synergia/Synergolf/SynerGolf.pptx

SynerGolf

Michał Szlachetka 205684
Marcin Trojan 205608
Jakub Trzyna 205687

## Slide 2

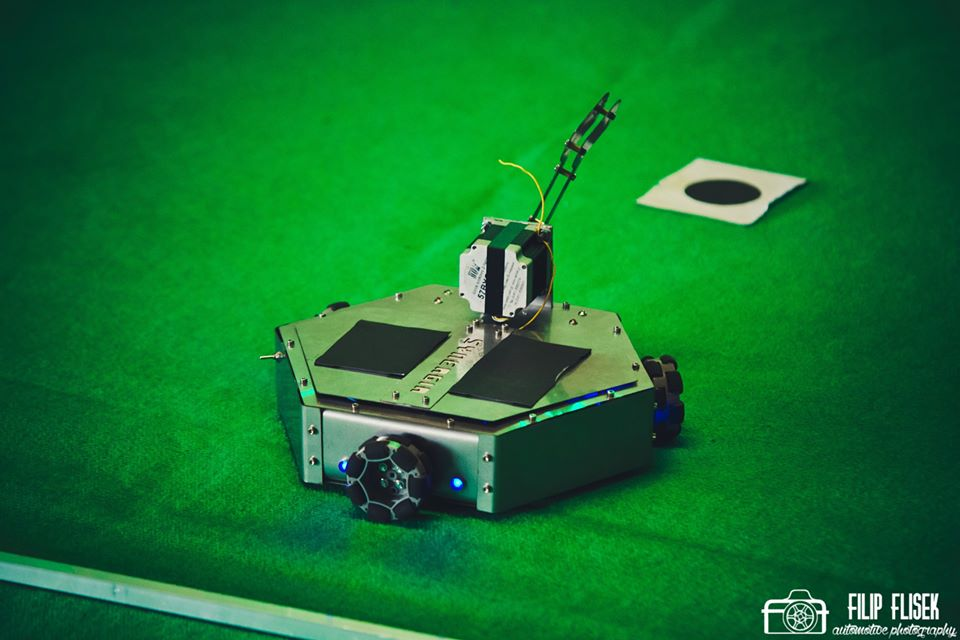
[picture p2: figure]

## Założenia

W skład „SynerGolfa” wchodzą :
- Dwuczęściowy aluminiowy kij
- Otwierana klapa
- Silnik krokowy
- Silniki DC
- Koła Omni Wheels
- Obudowa

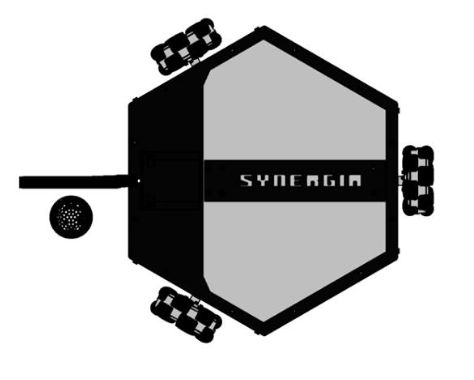
[picture p3: figure]
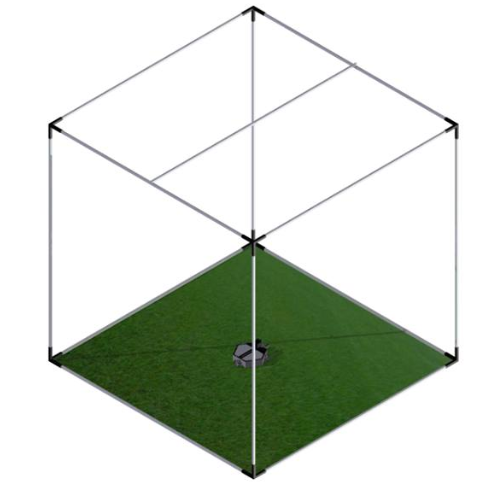
[picture p4: figure]
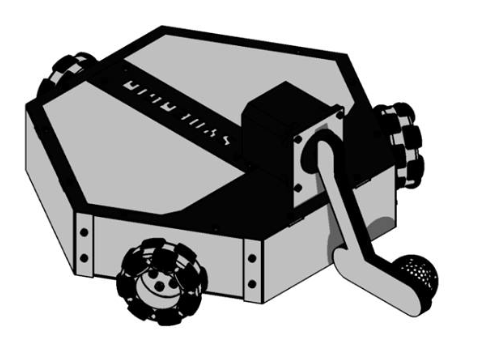
[picture p5: figure]

## Mechanika

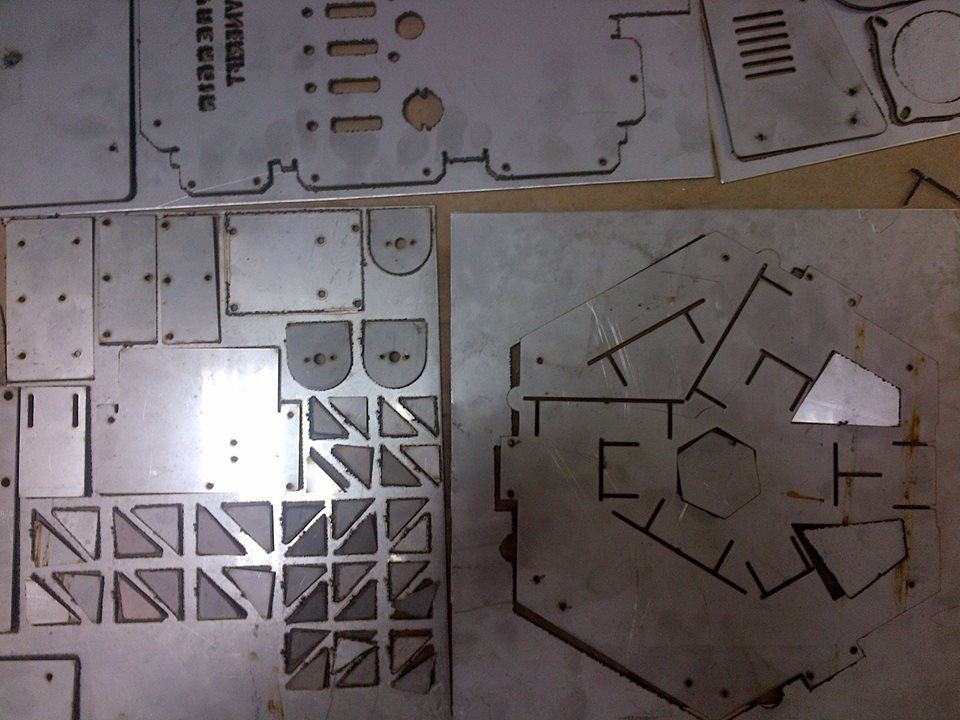
[picture p6: figure]

## Spawanie

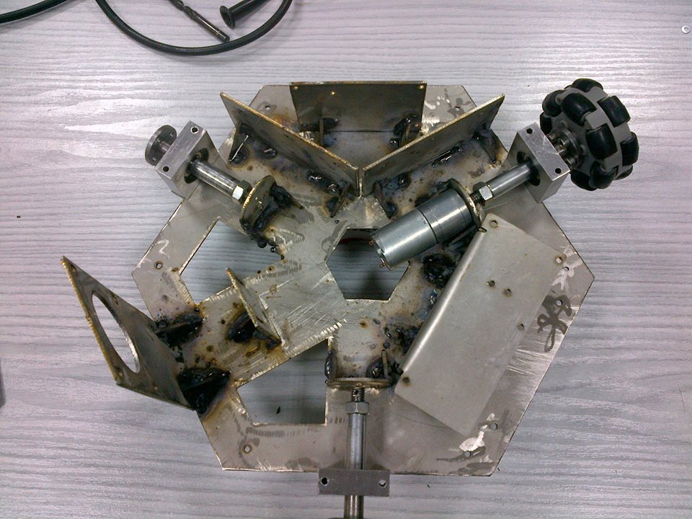
[picture p7: figure]

## Analiza obrazu

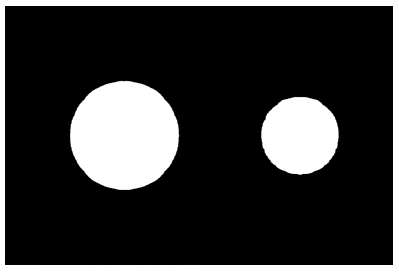
[picture p8: figure]
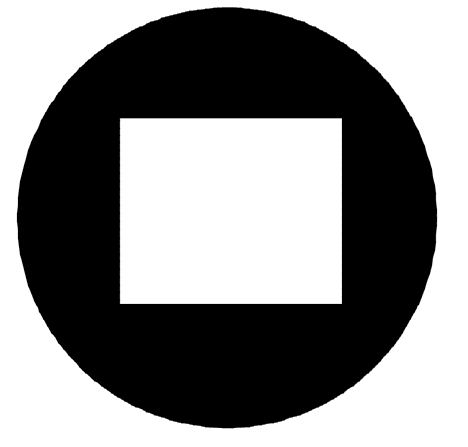
[picture p9: figure]
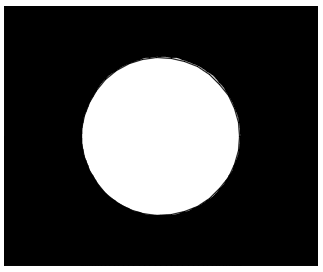
[picture p10: figure]
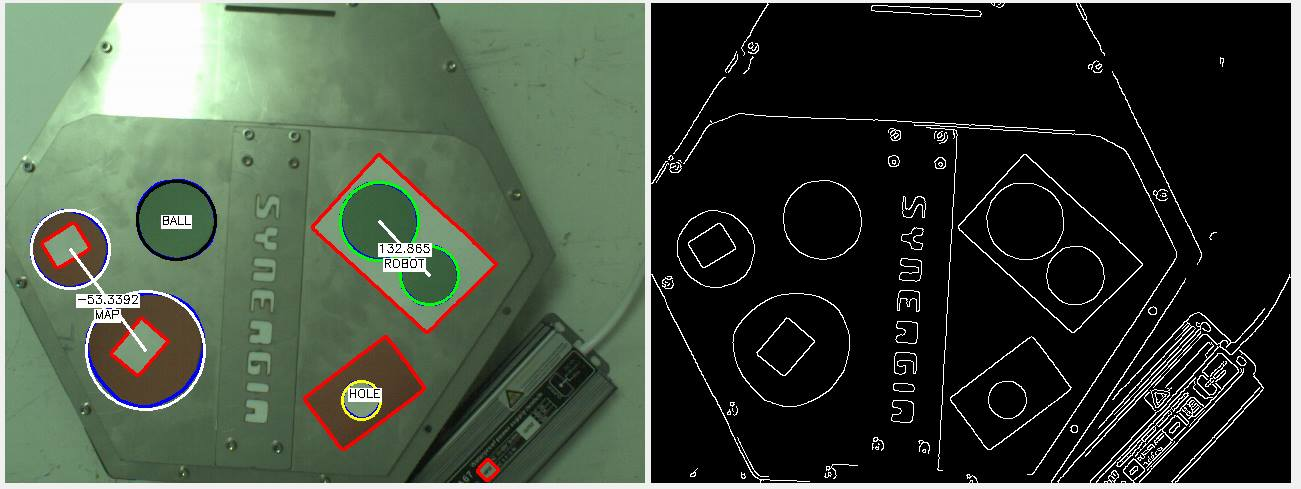
[picture p11: figure]

## Elektronika

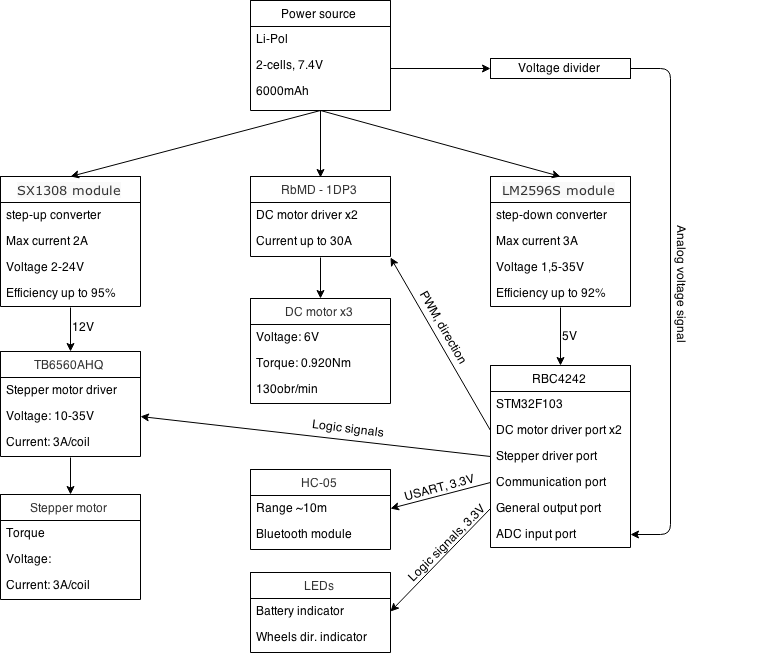
[picture p12: figure]

## Rozplanowanie

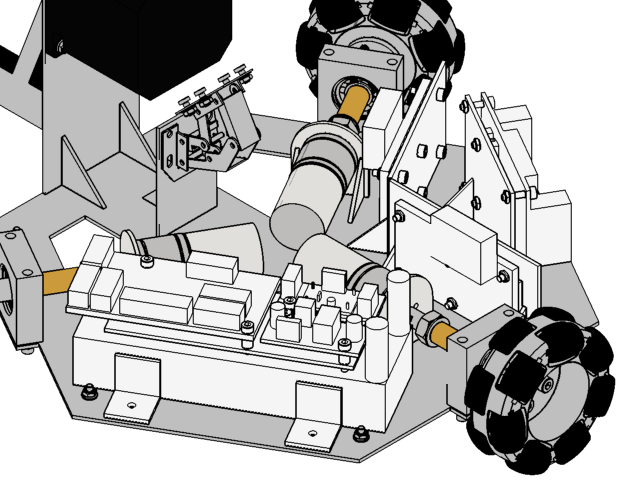
[picture p13: figure]
