synergia/Synergolf/model/GOLF/eksport do dxf.pdf

1. Utworzyć rozwinięcie blachy

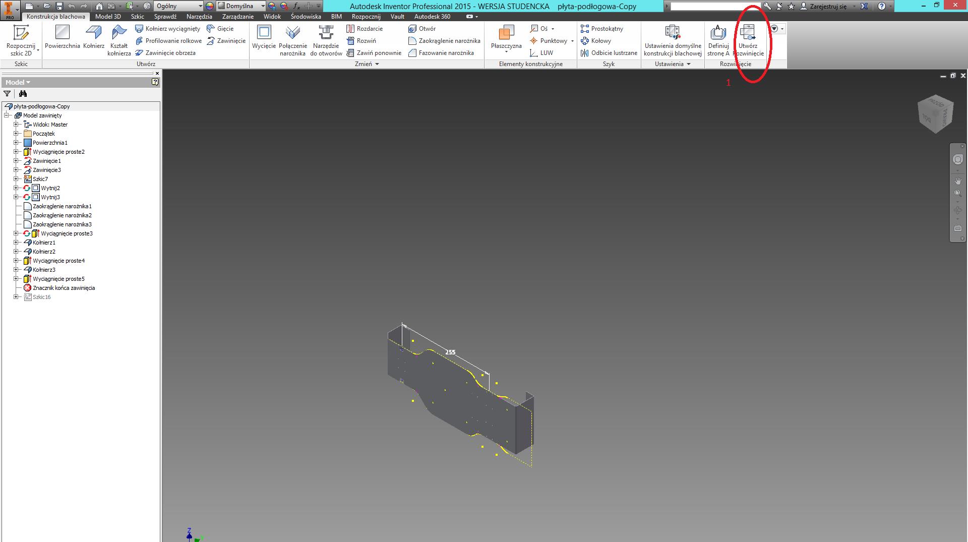
[picture p14: figure]

2. Tworzenie pliku dokumentacji technicznej

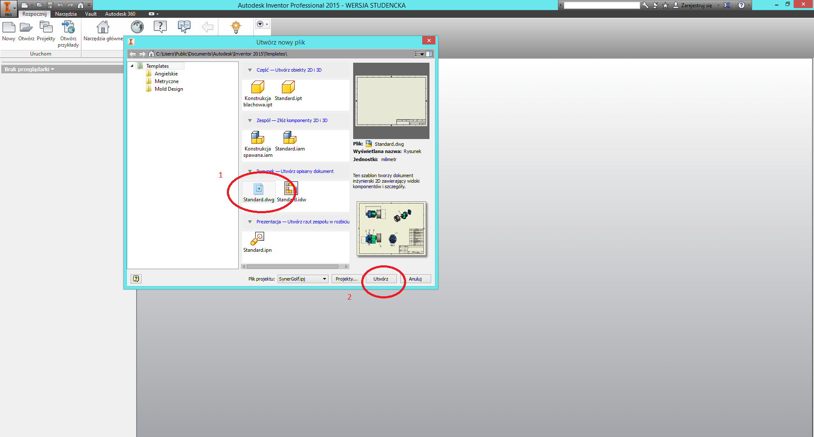
[picture p15: figure]

3. Ustawienie arkusza na odpowiedni wymiar (chyba nie jest konieczne, ale wydaje się być bardziej naturalne). PPM na arkuszu

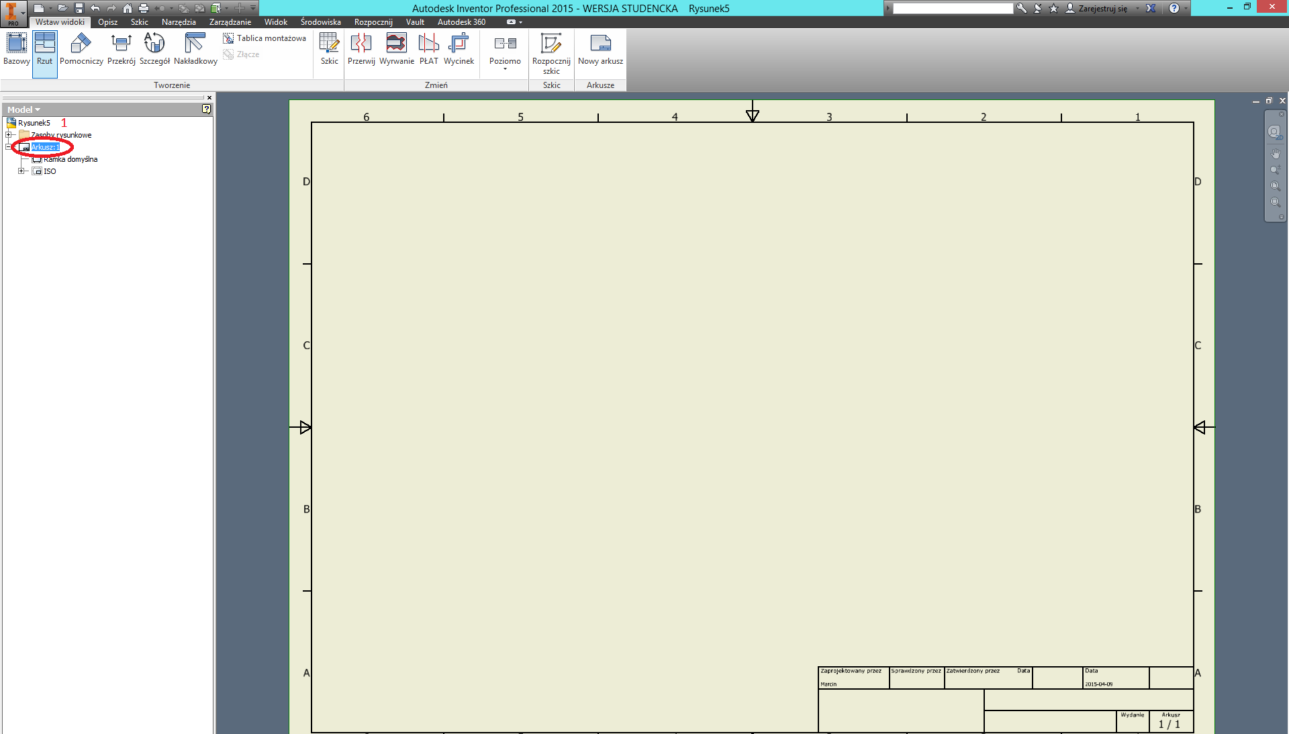
[picture p16: figure]

4. C.d.

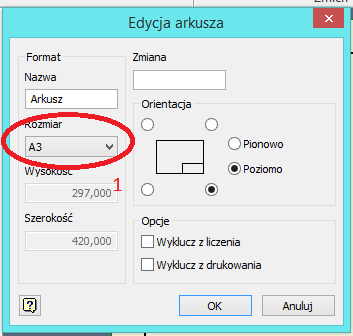
[picture p17: figure]

5. Tworzenie rzutu 2d

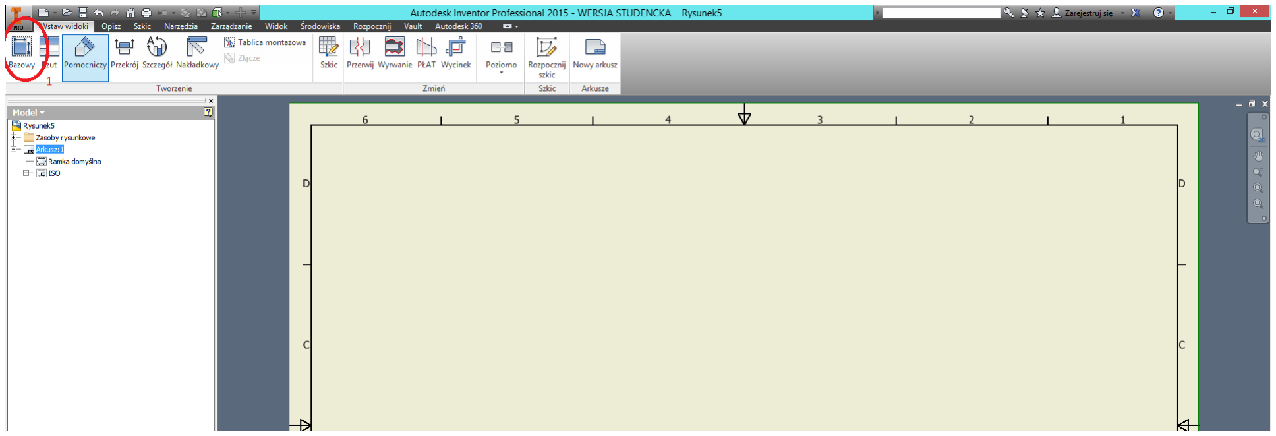
[picture p18: figure]

6. Lokalizacja pliku. Tu jest zaznaczona skala 1:1. Na następnym slajdzie ustawiło się przypadkiem 1:4, ale w rezultacie nie miało to wpływu na końcowy efekt

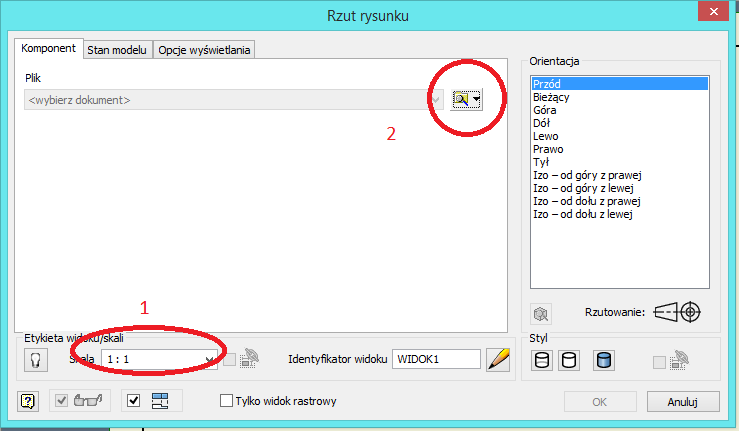
[picture p19: figure]

7. Wybranie opcji „rozwinięcie blachy”. Ta opcja jest niedostępna jeżeli nie utworzony został plik rozwinięcia blachy.

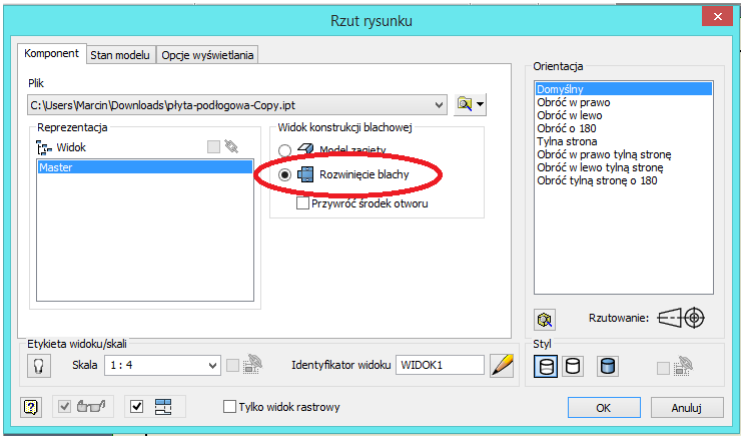
[picture p20: figure]

8. Teraz trzeba umieścić model na środku arkusza, nie naciskając LMP. Po umieszczeniu elementu należy nacisnąć PPM i wybrać „OK”.

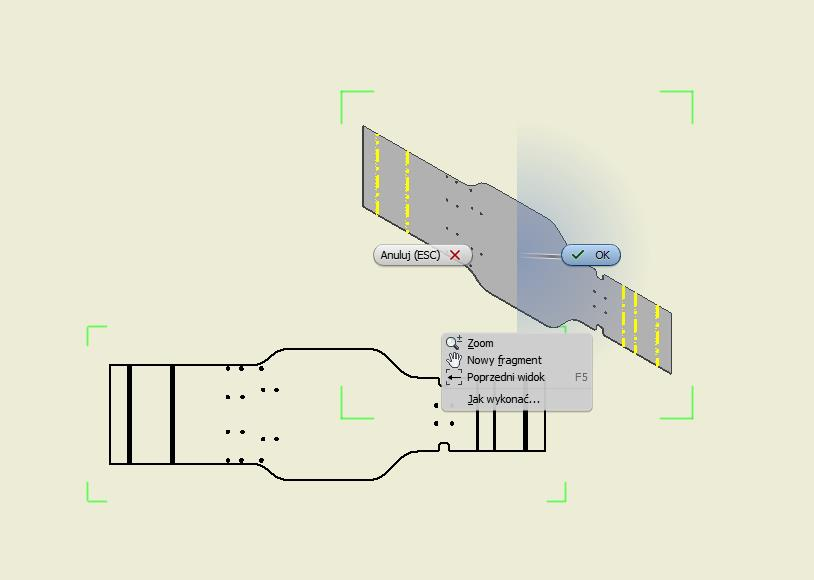
[picture p21: figure]

9. Zapisywanie

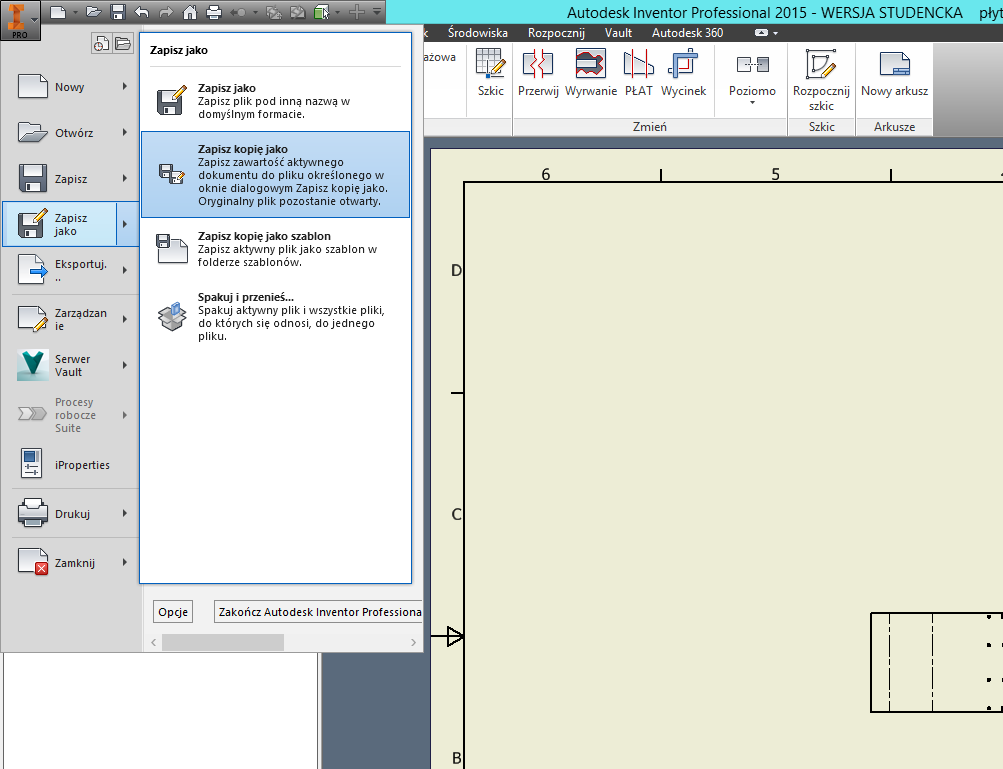
[picture p22: figure]

10. C.d.

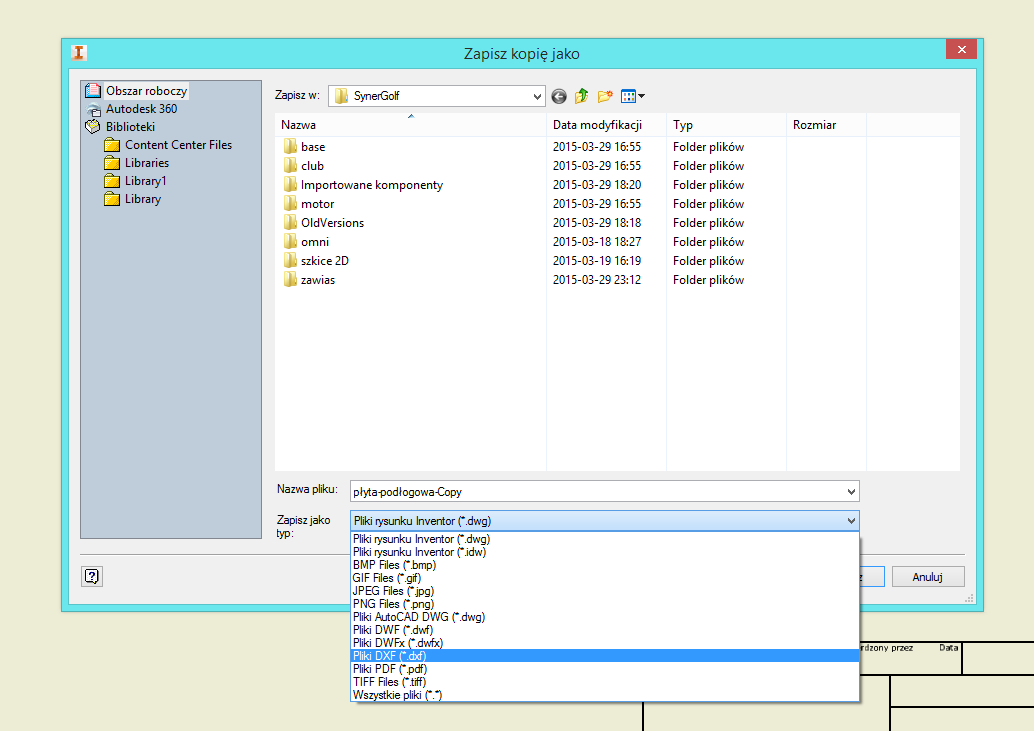
[picture p23: figure]

11. Otwieramy AutoCada.

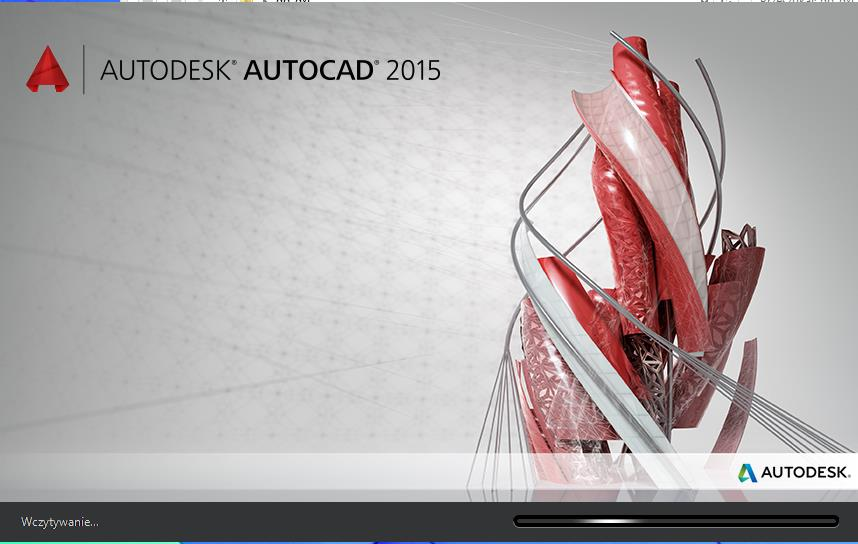
[picture p24: figure]

12. Usuwamy niepotrzebną ramkę.

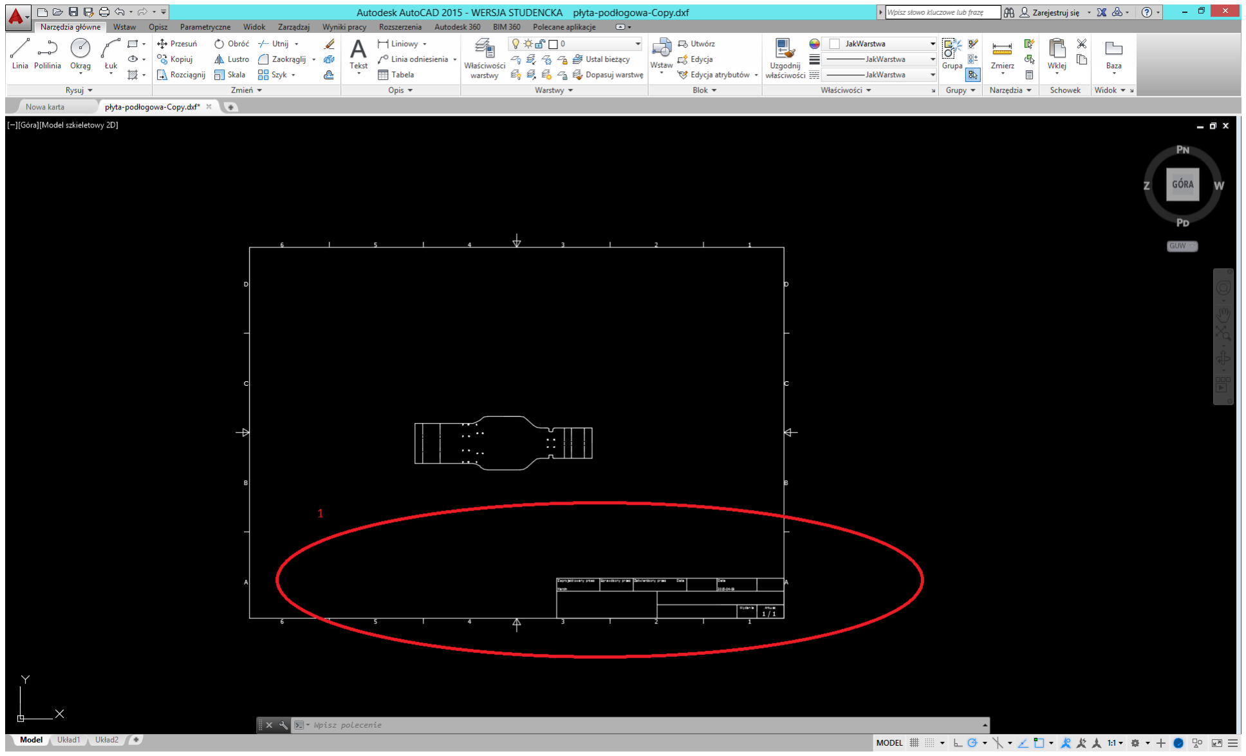
[picture p25: figure]

13. Usuwamy linie gięcia blachy.

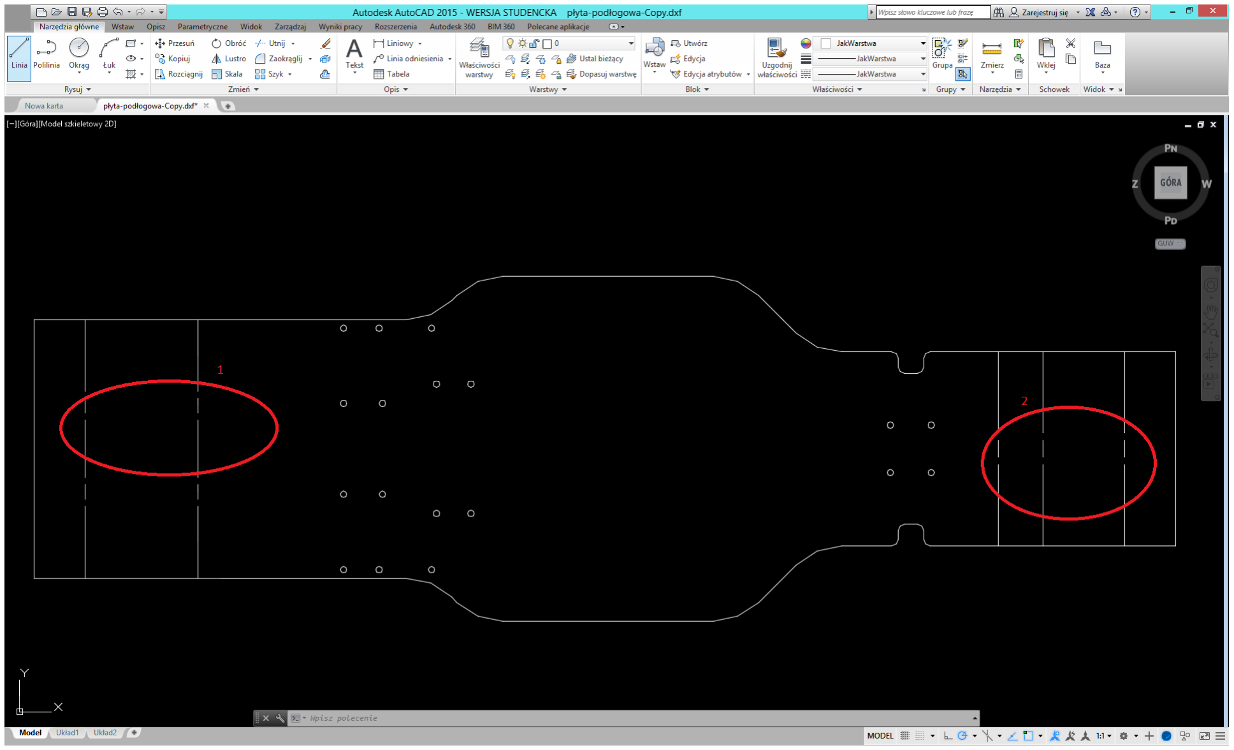
[picture p26: figure]

14. Sprawdzamy czy wszystkie splajny są przybliżone okręgami.

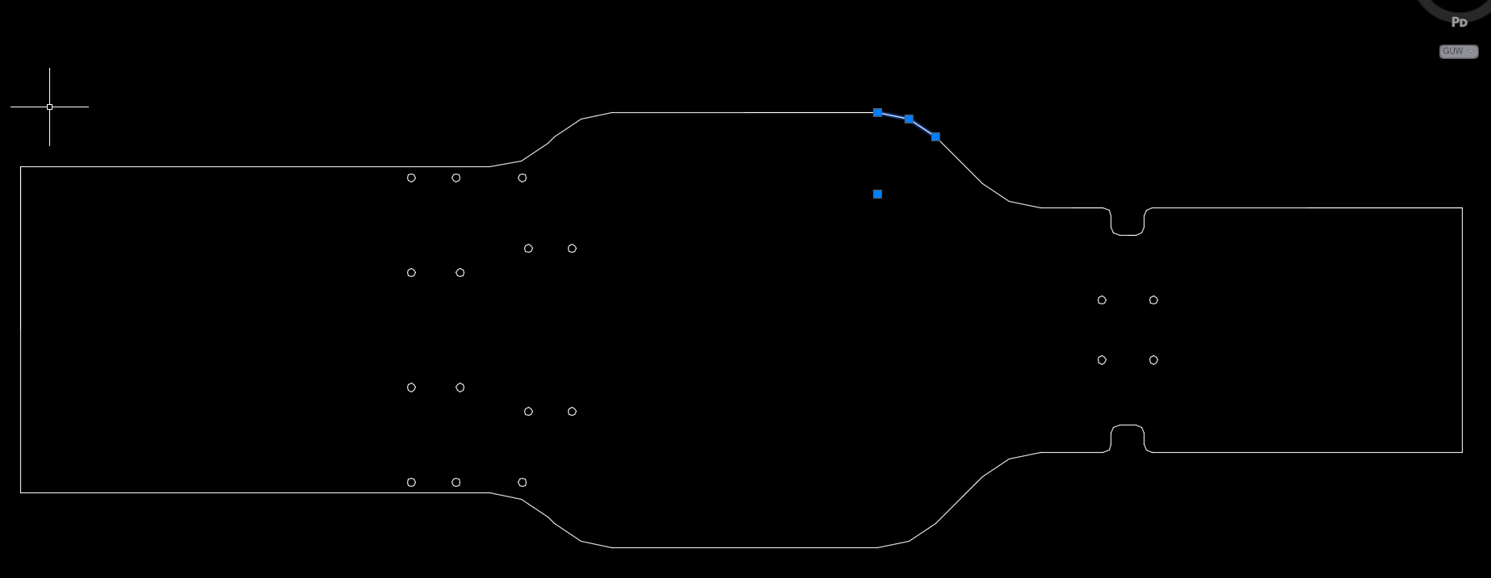
[picture p27: figure]

15. Grupujemy element. Bardzo ułatwia to później edycję programu.

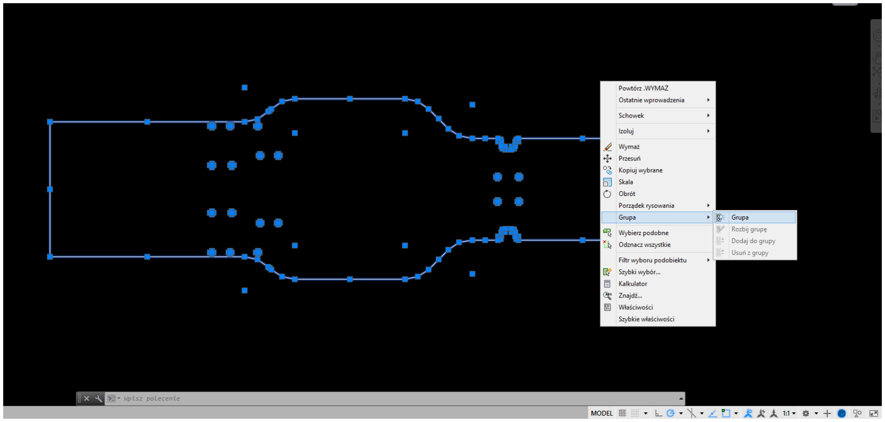
[picture p28: figure]

16. Zapisujemy jako DXF. Im starsza wersja tym lepiej.

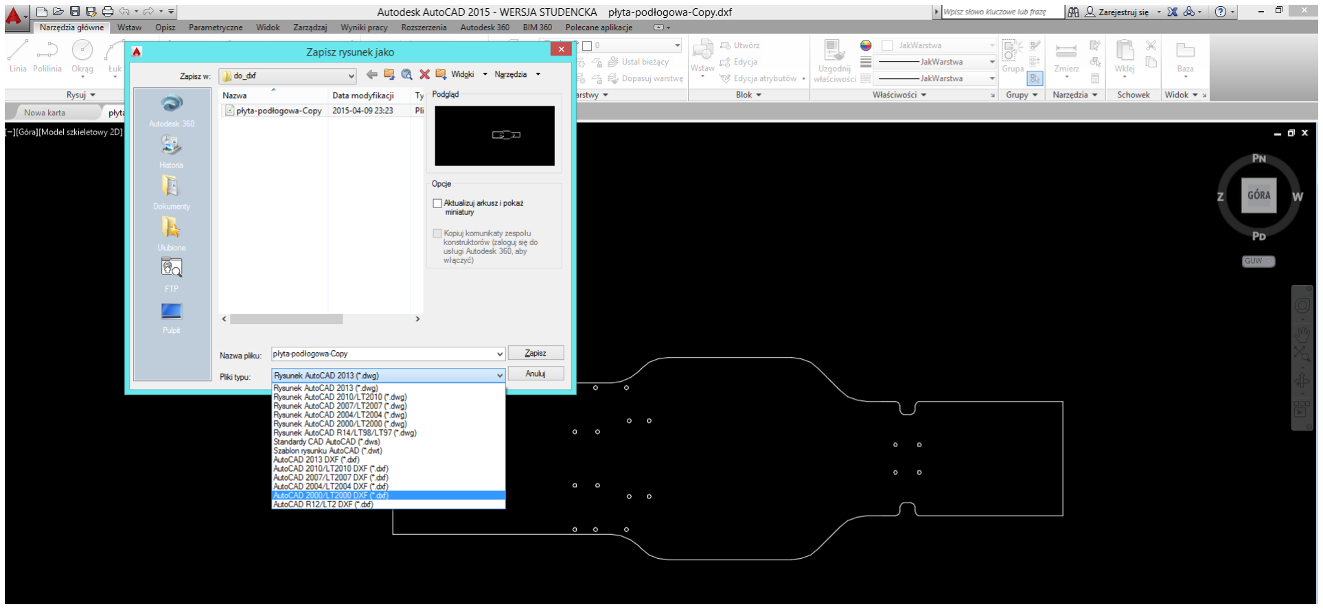
[picture p29: figure]

17. Przy wyłączeniu rysunku autocad proponuje zapisanie pliku w nowszym formacie. Odmawiamy

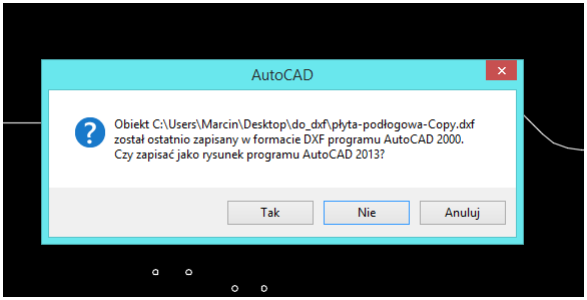
[picture p30: figure]
