synergia/Synergolf/model/GOLF/rendery/dc1.bmp

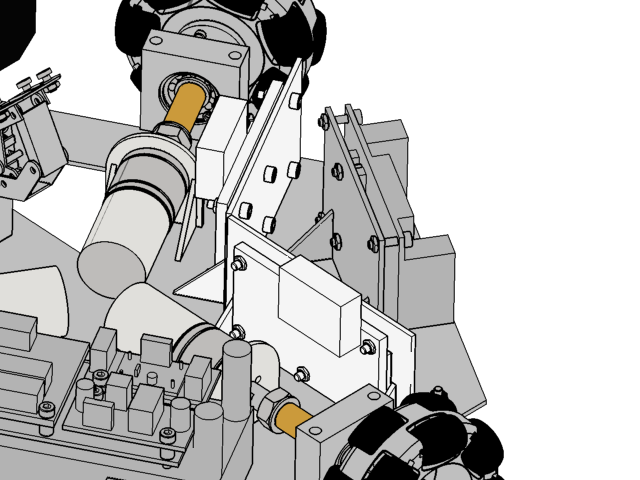
model/GOLF/rendery/dc1.bmp
