synergia/Synergolf/model/GOLF/rendery/supp1.bmp

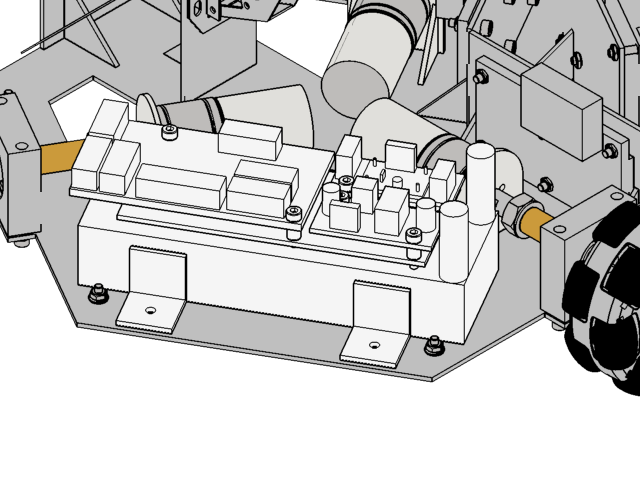
model/GOLF/rendery/supp1.bmp
