synergia/Synergolf/model/GOLF/rendery/supp2.bmp

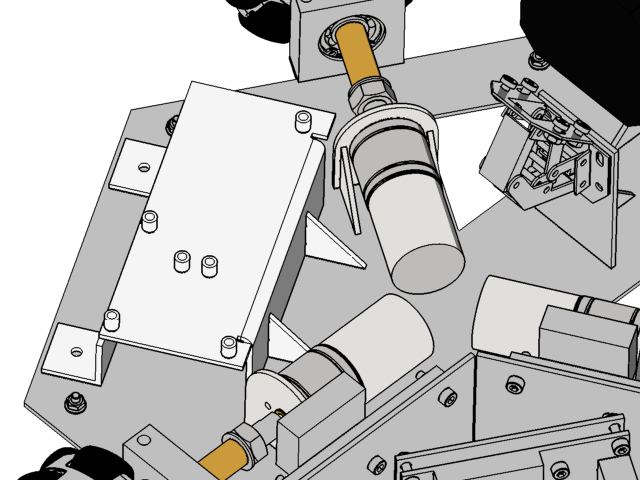
model/GOLF/rendery/supp2.bmp
