synergia/Synergolf/model/GOLF/dxf/batt-logic support.dxf

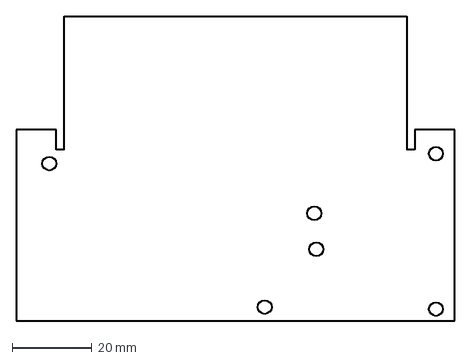
[picture p34: CAD file, 2015-05-10]
model/GOLF/dxf/batt-logic support.dxf
110.0 x 76.5 mm
