synergia/Synergolf/model/GOLF/dxf/mostekH.dxf

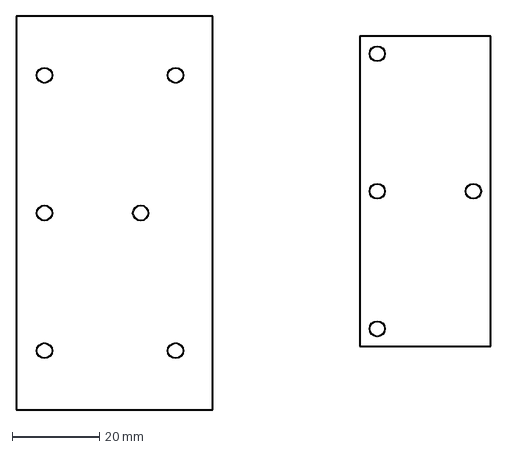
[picture p35: CAD file, 2015-05-10]
model/GOLF/dxf/mostekH.dxf
108.7 x 90.0 mm
