synergia/Synergolf/model/GOLF/dxf/base_constr.dxf

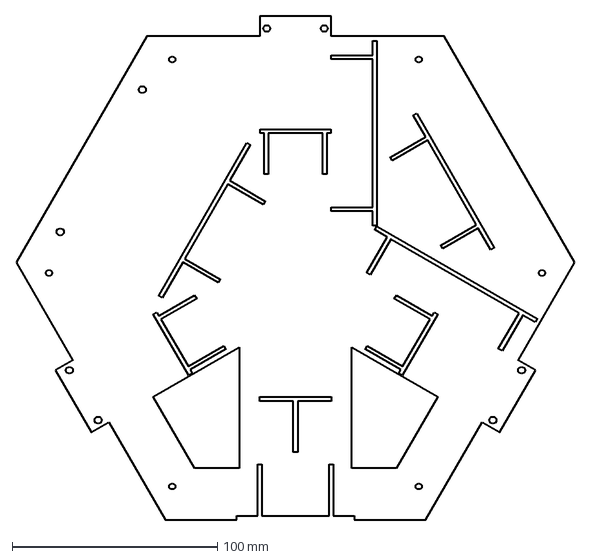
[picture p36: CAD file, 2015-05-10]
model/GOLF/dxf/base_constr.dxf
271.7 x 245.2 mm
