synergia/Synergolf/model/GOLF/dxf/blacha pionowa step driver.dxf

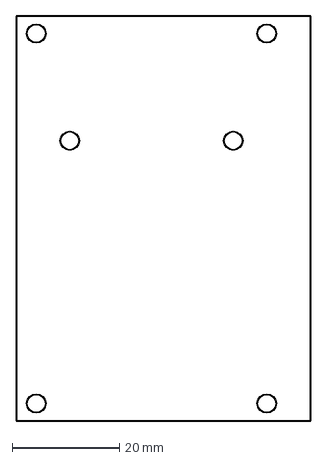
[picture p37: CAD file, 2015-05-10]
model/GOLF/dxf/blacha pionowa step driver.dxf
55.0 x 75.5 mm
