synergia/Synergolf/model/GOLF/dxf/laser.dxf

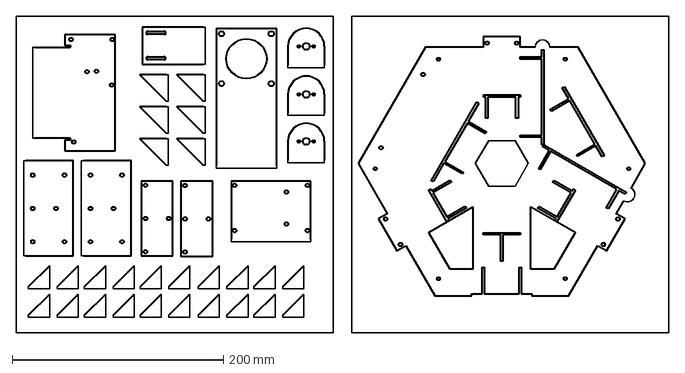
[picture p38: CAD file, 2015-05-10]
model/GOLF/dxf/laser.dxf
617.4 x 300.0 mm
