synergia/Synergolf/model/GOLF/dxf/wspornik.dxf

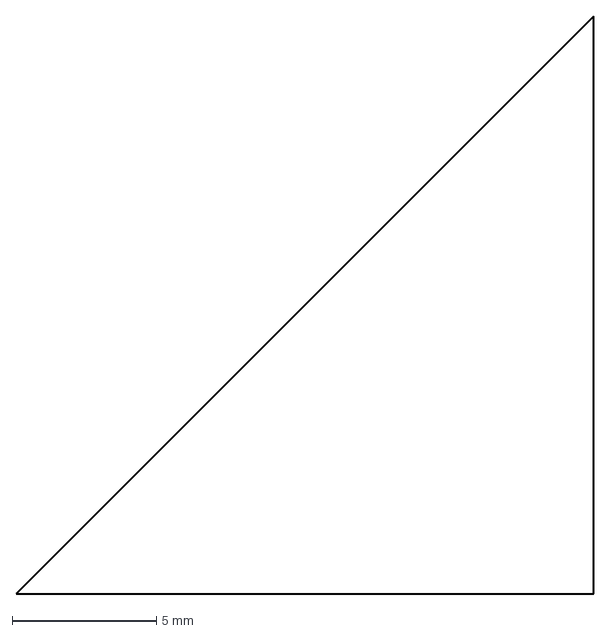
[picture p39: CAD file, 2015-05-10]
model/GOLF/dxf/wspornik.dxf
20.0 x 20.0 mm
