synergia/Synergolf/(list of files, cad)

Other CAD files:
model/GOLF/Templates/Angielskie/am_ansi.dwg
model/GOLF/Templates/Metryczne/JIS.dwg
model/GOLF/Templates/Standard.dwg
model/GOLF/Templates/Angielskie/ANSI (cal).dwg
model/GOLF/Templates/Metryczne/am_bsi.dwg
model/GOLF/Templates/Metryczne/am_gb.dwg
model/GOLF/Templates/Metryczne/am_din.dwg
model/GOLF/Templates/Metryczne/BSI.dwg
model/GOLF/dxf/blacha pionowa.dwg
model/GOLF/Templates/Metryczne/ANSI (mm).dwg
model/GOLF/Templates/Metryczne/GB.dwg
model/GOLF/dxf/blacha pionowa ste driver.dwg
model/GOLF/Templates/Metryczne/GOST.dwg
model/GOLF/Templates/Metryczne/ISO.dwg
model/GOLF/Templates/Metryczne/am_jis.dwg
model/GOLF/Templates/Metryczne/am_iso.dwg
model/GOLF/Templates/Metryczne/DIN.dwg
model/GOLF/20126_3D1.ipt
model/GOLF/ASM-SMALL-WHEEL_ASM.iam
model/GOLF/ContentCenter/pl-PL/DIN 439-2/DIN 439 - M2,5 x 0,45.ipt
model/GOLF/ContentCenter/pl-PL/DIN 439-2/DIN 439 - M3 x 0,5.ipt
model/GOLF/ContentCenter/pl-PL/DIN 912/DIN 912 - M2,5 x 0,45 x 12 x 10,875.ipt
model/GOLF/ContentCenter/pl-PL/DIN 912/DIN 912 - M3 x 0,5 x 10 x 8,75.ipt
model/GOLF/ContentCenter/pl-PL/DIN 912/DIN 912 - M3 x 0,5 x 12 x 10,75.ipt
model/GOLF/ContentCenter/pl-PL/DIN 912/DIN 912 - M3 x 0,5 x 5 x 3,75.ipt
model/GOLF/DIN 472 - 22x1.ipt
model/GOLF/DIN 555-5 - M8.ipt
model/GOLF/DIN 630 - 108 - 8 x 22 x 7.ipt
model/GOLF/DIN 6912 - M4 x 10.ipt
model/GOLF/DIN 7984 - M3 x 12.ipt
model/GOLF/DIN 7984 - M3 x 5.ipt
model/GOLF/DIN 7984 - M3 x 6.ipt
model/GOLF/DIN 7984 - M3 x 8.ipt
model/GOLF/DIN 988 - 8 x 14 x 1.ipt
model/GOLF/Design Data/AIT/Mold Design/mold design stop pin.ipt
model/GOLF/Design Data/Cable & Harness/pl-PL/harness.iam
model/GOLF/Design Data/Tube & Pipe/pl-PL/piping runs.iam
model/GOLF/ISO 4032 - M3ISO.ipt
model/GOLF/ISO 4762 - M3 x 5ISO.ipt
model/GOLF/ISO 7089 - 3 - 140 HV(1).ipt
model/GOLF/MostekH.ipt
model/GOLF/OldVersions/ASM-SMALL-WHEEL_ASM.0003.iam
model/GOLF/OldVersions/MostekH.0001.ipt
model/GOLF/OldVersions/Połączenie gwintowe1.0001.iam
model/GOLF/OldVersions/Połączenie gwintowe10.0001.iam
model/GOLF/OldVersions/Połączenie gwintowe11.0001.iam
model/GOLF/OldVersions/Połączenie gwintowe12.0001.iam
model/GOLF/OldVersions/Połączenie gwintowe13.0001.iam
model/GOLF/OldVersions/Połączenie gwintowe14.0001.iam
model/GOLF/OldVersions/Połączenie gwintowe15.0001.iam
model/GOLF/OldVersions/Połączenie gwintowe16.0001.iam
model/GOLF/OldVersions/Połączenie gwintowe17.0001.iam
model/GOLF/OldVersions/Połączenie gwintowe18.0001.iam
model/GOLF/OldVersions/Połączenie gwintowe19.0001.iam
model/GOLF/OldVersions/Połączenie gwintowe20.0001.iam
model/GOLF/OldVersions/Połączenie gwintowe21.0001.iam
model/GOLF/OldVersions/RBC4242.0001.ipt
model/GOLF/OldVersions/base_all.0053.iam
model/GOLF/OldVersions/base_const_al.0022.iam
model/GOLF/OldVersions/base_constr.0011.ipt
model/GOLF/OldVersions/bearing_all.0003.iam
model/GOLF/OldVersions/club_ABS_all.0005.iam
model/GOLF/OldVersions/console.0003.ipt
model/GOLF/OldVersions/hettich.0002.ipt
model/GOLF/OldVersions/hettich_1.0004.ipt
model/GOLF/OldVersions/hettlich_2.0001.ipt
model/GOLF/OldVersions/hettlich_3.0002.ipt
model/GOLF/OldVersions/hettlich_4.0001.ipt
model/GOLF/OldVersions/hettlich_5.0001.ipt
model/GOLF/OldVersions/hettlich_6.0001.ipt
model/GOLF/OldVersions/lipol_6000.0001.ipt
model/GOLF/OldVersions/martro_hettlich.0022.iam
model/GOLF/OldVersions/mot_wheel.0022.iam
model/GOLF/OldVersions/motor_all.0006.iam
model/GOLF/OldVersions/motor_all.0007.iam
model/GOLF/OldVersions/omni.0004.iam
model/GOLF/OldVersions/stepper_large_all.0006.iam
model/GOLF/Połączenie gwintowe1.iam
model/GOLF/Połączenie gwintowe10.iam
model/GOLF/Połączenie gwintowe11.iam
model/GOLF/Połączenie gwintowe12.iam
model/GOLF/Połączenie gwintowe13.iam
model/GOLF/Połączenie gwintowe14.iam
model/GOLF/Połączenie gwintowe15.iam
model/GOLF/Połączenie gwintowe16.iam
model/GOLF/Połączenie gwintowe17.iam
model/GOLF/Połączenie gwintowe18.iam
model/GOLF/Połączenie gwintowe19.iam
model/GOLF/Połączenie gwintowe20.iam
model/GOLF/Połączenie gwintowe21.iam
model/GOLF/RBC4242.ipt
model/GOLF/SMALL-HUB.ipt
model/GOLF/SMALL-RUBBER-WHEEL.ipt
model/GOLF/SMALL-WHEEL-AXIS.ipt
model/GOLF/Templates/Angielskie/ANSI (cal).idw
model/GOLF/Templates/Angielskie/Konstrukcja blachowa (cal).ipt
model/GOLF/Templates/Angielskie/Konstrukcja spawana (ANSI).iam
model/GOLF/Templates/Angielskie/Mold Design (cal).iam
model/GOLF/Templates/Angielskie/Standard (cal).iam
model/GOLF/Templates/Angielskie/Standard (cal).ipn
model/GOLF/Templates/Angielskie/Standard (cal).ipt
model/GOLF/Templates/Konstrukcja blachowa.ipt
model/GOLF/Templates/Konstrukcja spawana.iam
model/GOLF/Templates/Metryczne/ANSI (mm).idw
model/GOLF/Templates/Metryczne/BSI.idw
model/GOLF/Templates/Metryczne/DIN.idw
model/GOLF/Templates/Metryczne/GB.idw
model/GOLF/Templates/Metryczne/GOST.idw
model/GOLF/Templates/Metryczne/ISO.idw
model/GOLF/Templates/Metryczne/JIS.idw
model/GOLF/Templates/Metryczne/Konstrukcja blachowa (DIN).ipt
model/GOLF/Templates/Metryczne/Konstrukcja blachowa (mm).ipt
model/GOLF/Templates/Metryczne/Konstrukcja spawana (ANSI - mm).iam
model/GOLF/Templates/Metryczne/Konstrukcja spawana (BSI).iam
model/GOLF/Templates/Metryczne/Konstrukcja spawana (DIN).iam
model/GOLF/Templates/Metryczne/Konstrukcja spawana (GB).iam
model/GOLF/Templates/Metryczne/Konstrukcja spawana (ISO).iam
model/GOLF/Templates/Metryczne/Konstrukcja spawana (JIS).iam
model/GOLF/Templates/Metryczne/Mold Design (DIN).iam
model/GOLF/Templates/Metryczne/Mold Design (mm).iam
model/GOLF/Templates/Metryczne/Standard (DIN).iam
model/GOLF/Templates/Metryczne/Standard (DIN).ipn
model/GOLF/Templates/Metryczne/Standard (DIN).ipt
model/GOLF/Templates/Metryczne/Standard (mm).iam
model/GOLF/Templates/Metryczne/Standard (mm).ipn
model/GOLF/Templates/Metryczne/Standard (mm).ipt
model/GOLF/Templates/Mold Design/Mold Design.iam
model/GOLF/Templates/Standard.iam
model/GOLF/Templates/Standard.idw
model/GOLF/Templates/Standard.ipn
model/GOLF/Templates/Standard.ipt
model/GOLF/base_all.iam
model/GOLF/base_bottom.ipt
model/GOLF/base_const_al.iam
model/GOLF/base_constr.ipt
model/GOLF/base_side.idw
model/GOLF/base_side.ipt
model/GOLF/base_side_constr.idw
model/GOLF/base_side_constr.ipt
model/GOLF/base_top.ipt
model/GOLF/batt support/OldVersions/batt support.0003.iam
model/GOLF/batt support/OldVersions/batt support.0005.iam
model/GOLF/batt support/OldVersions/batt support.0014.iam
model/GOLF/batt support/OldVersions/batt-logic support.0005.ipt
model/GOLF/batt support/OldVersions/batt-logic support.0011.ipt
model/GOLF/batt support/OldVersions/dociskacz.0001.ipt
model/GOLF/batt support/OldVersions/step down.0001.ipt
model/GOLF/batt support/batt support.iam
model/GOLF/batt support/batt-logic support.ipt
model/GOLF/batt support/dociskacz.ipt
model/GOLF/batt support/dystans rbc.ipt
model/GOLF/batt support/mocowanie logiki.ipt
model/GOLF/batt support/step down.ipt
model/GOLF/batt support/step up.ipt
model/GOLF/bearing_all.iam
model/GOLF/bearing_frame.idw
model/GOLF/bearing_frame.ipt
model/GOLF/club_ABS.ipt
model/GOLF/club_ABS_all.iam
model/GOLF/club_ABS_metal.ipt
model/GOLF/console.ipt
model/GOLF/cover.ipt
model/GOLF/driver/OldVersions/motor driver support.0003.iam
model/GOLF/driver/OldVersions/motor driver support.0004.iam
model/GOLF/driver/OldVersions/wspornik.0001.ipt
model/GOLF/driver/blacha pionowa.ipt
model/GOLF/driver/docisk do mostka.ipt
model/GOLF/driver/motor driver support.iam
model/GOLF/driver/wspornik.ipt
model/GOLF/dxf/OldVersions/base_constr.0001.dwg
model/GOLF/dxf/base_constr.dwg
model/GOLF/dxf/batt-logic support.dwg
model/GOLF/dxf/wspornik.dwg
model/GOLF/golf ball.ipt
model/GOLF/hettich.ipt
model/GOLF/hettich_1.ipt
model/GOLF/hettlich_2.ipt
model/GOLF/hettlich_3.ipt
model/GOLF/hettlich_4.ipt
model/GOLF/hettlich_5.ipt
model/GOLF/hettlich_6.ipt
model/GOLF/hinge_support.ipt
model/GOLF/laser_main.idw
model/GOLF/lipol_6000.ipt
model/GOLF/logo.ipt
model/GOLF/martro_hettlich.iam
model/GOLF/mot_wheel.iam
model/GOLF/motor_all.iam
model/GOLF/motor_dc.ipt
model/GOLF/omni.iam
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
