synergia/Synergolf/model/GOLF/rendery/step1.bmp

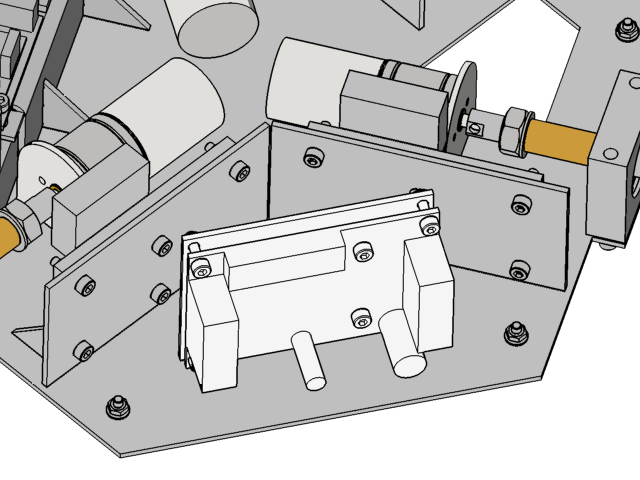
model/GOLF/rendery/step1.bmp
