synergia/Synergolf/model/GOLF/rendery/step2.bmp

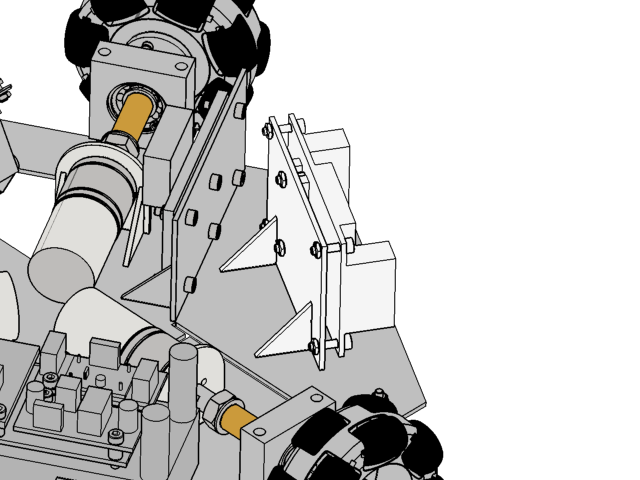
model/GOLF/rendery/step2.bmp
