synergia/Synergolf/Eagle/bt.pdf

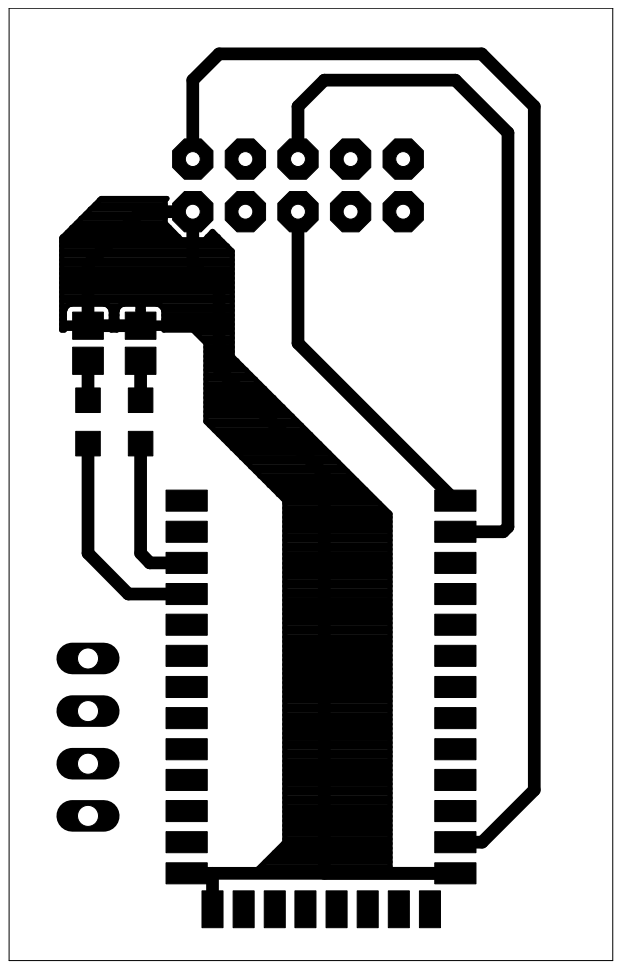
[picture p42: page 1]
