synergia/Synergolf/Eagle/converter adapter - Copy.pdf

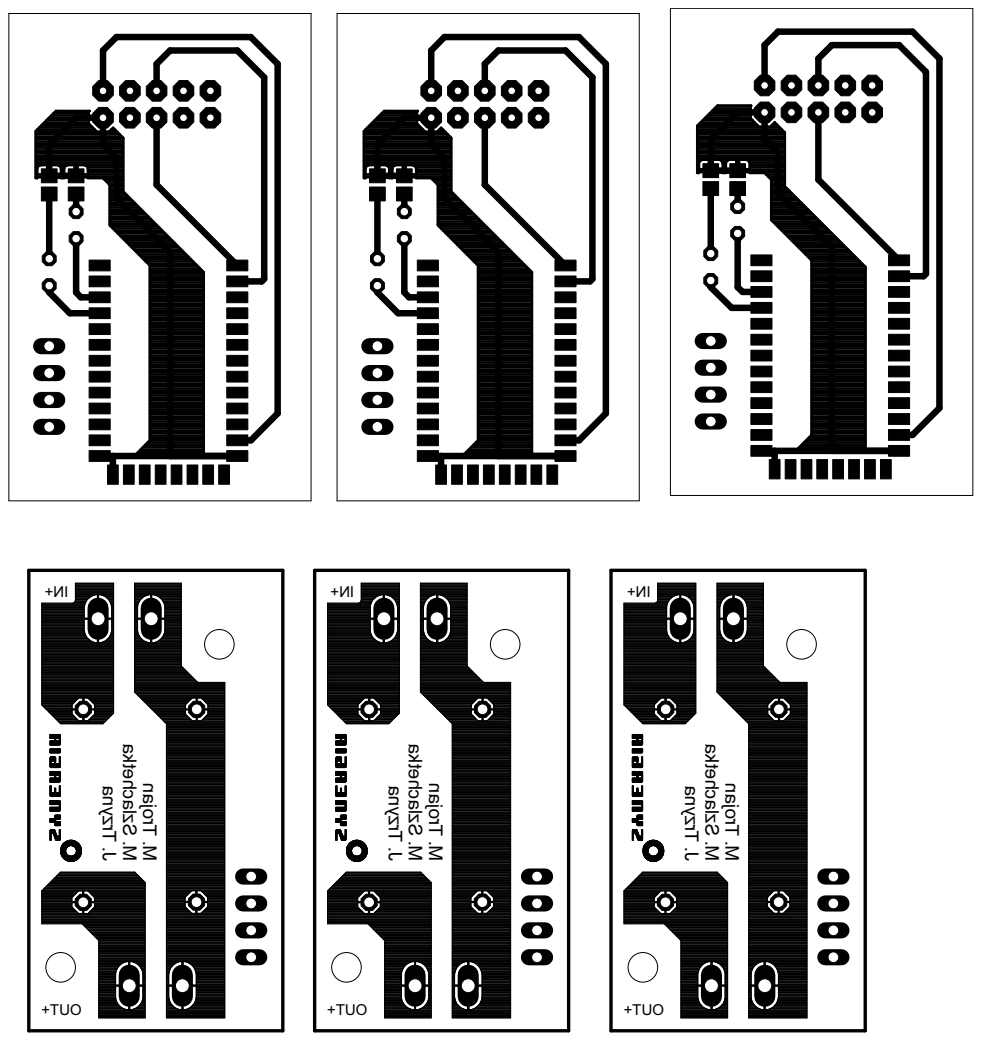
[picture p43: page 1]
