synergia/Synergolf/Eagle/bt - Copy (2).pdf

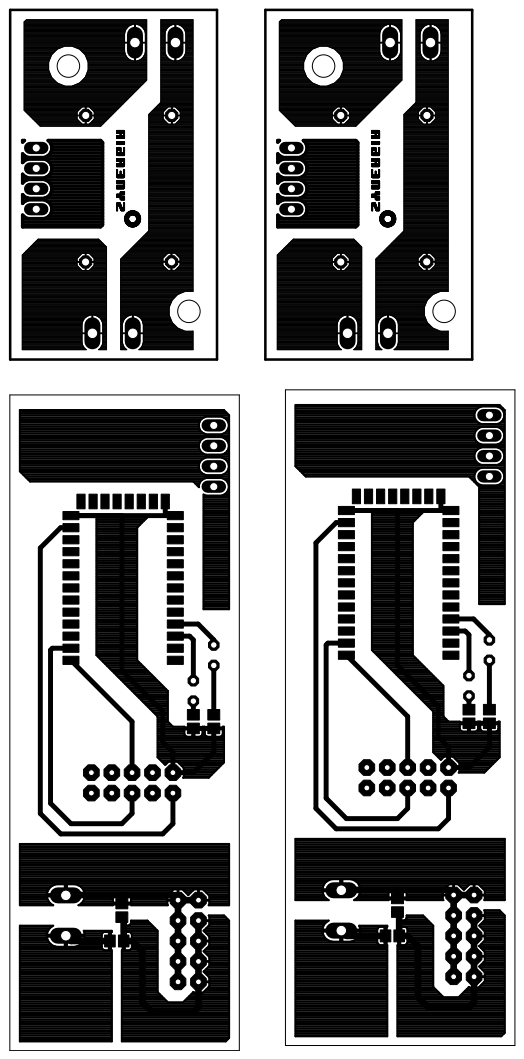
[picture p44: page 1]
