synergia/Synergolf/Eagle/bt.brd

## EAGLE design Eagle/bt.brd (2015-05-13)

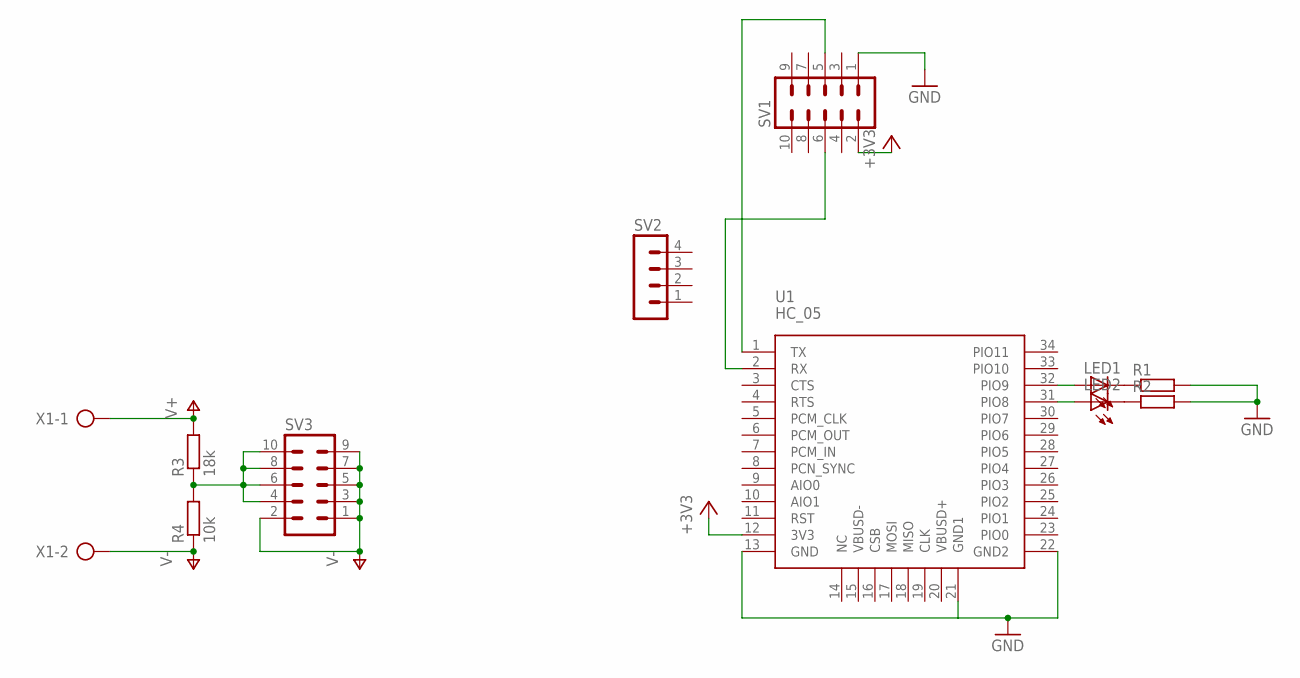
[picture p45: schematic bt.sch]

Parts:
LED1, LED2: LED3MM
R1, R2: R-EU_R0805; R0805
R3: 18k; R0805
R4: 10k; R0805
SV1, SV3: ML10
SV2: MA04-1
U1: HC_05; BLUETOOTH_SMD
X1: AK500/2

Connections:
+3V3: SV1.2, U1.12 (3V3)
GND: R1.2, R2.2, SV1.1, U1.13 (GND), U1.21 (GND1), U1.22 (GND2)
unnamed: SV1.5, U1.1 (TX)
unnamed: SV1.6, U1.2 (RX)
unnamed: LED1.K (C), R1.1
unnamed: LED2.K (C), R2.1
unnamed: LED2.A, U1.31 (PIO8)
unnamed: LED1.A, U1.32 (PIO9)
unnamed: R3.1, R4.2, SV3.4, SV3.6, SV3.8, SV3.10
V+: R3.2, X1.1
V-: R4.1, SV3.1, SV3.2, SV3.3, SV3.5, SV3.7, SV3.9, X1.2

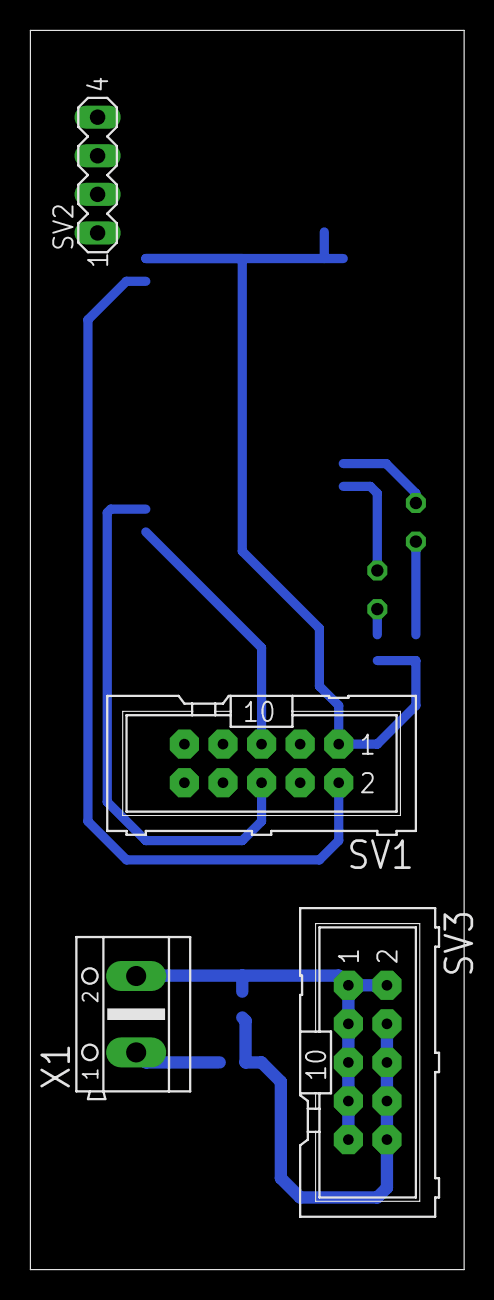
[picture p46: board bt.brd from above]

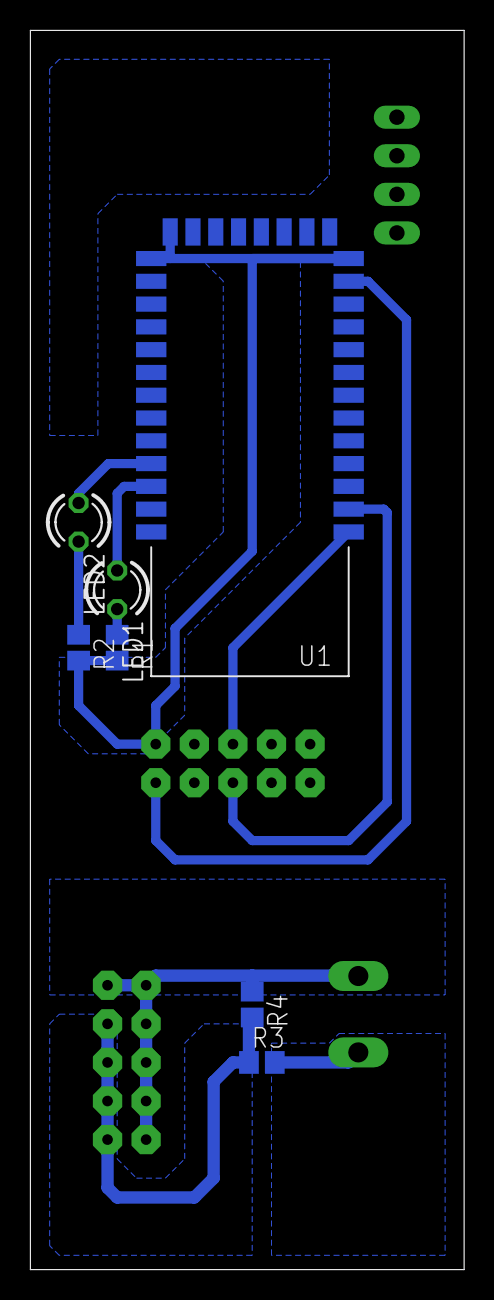
[picture p47: board bt.brd from below]

Board: 2 copper layers, 28.6 x 81.6 mm, 11 parts (7 on the bottom side), 11 nets.
