synergia/Synergolf/Eagle/converter adapter - Copy.brd

## EAGLE design Eagle/converter adapter - Copy.brd (2015-05-13)

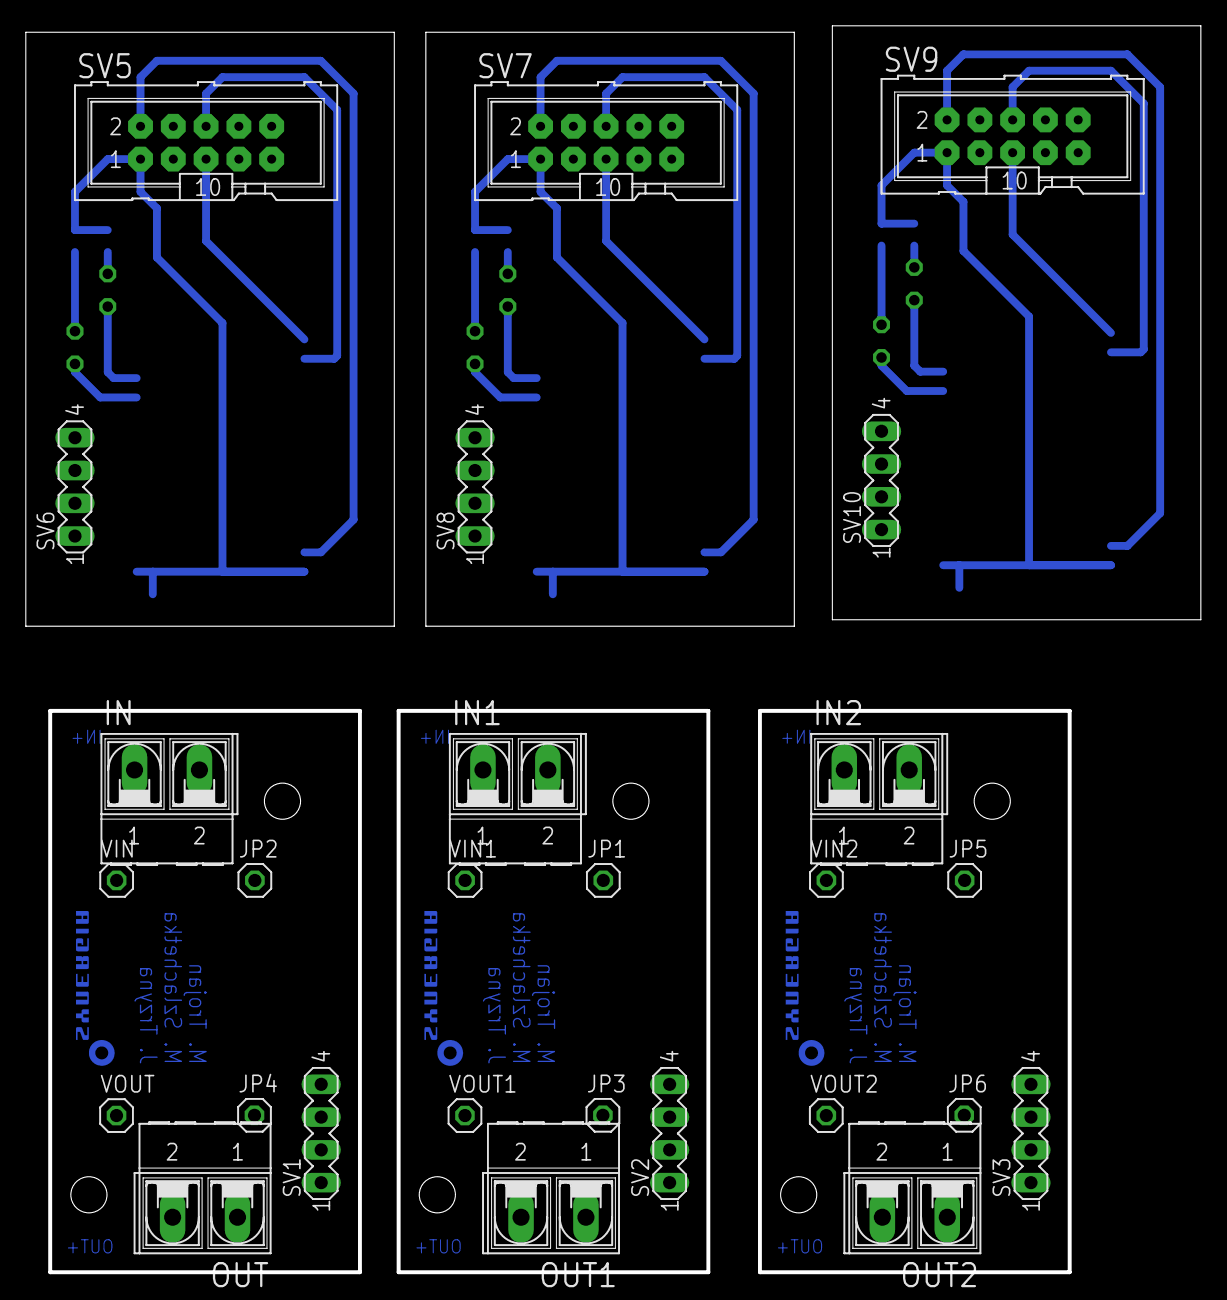
[picture p48: board converter adapter - Copy.brd from above]

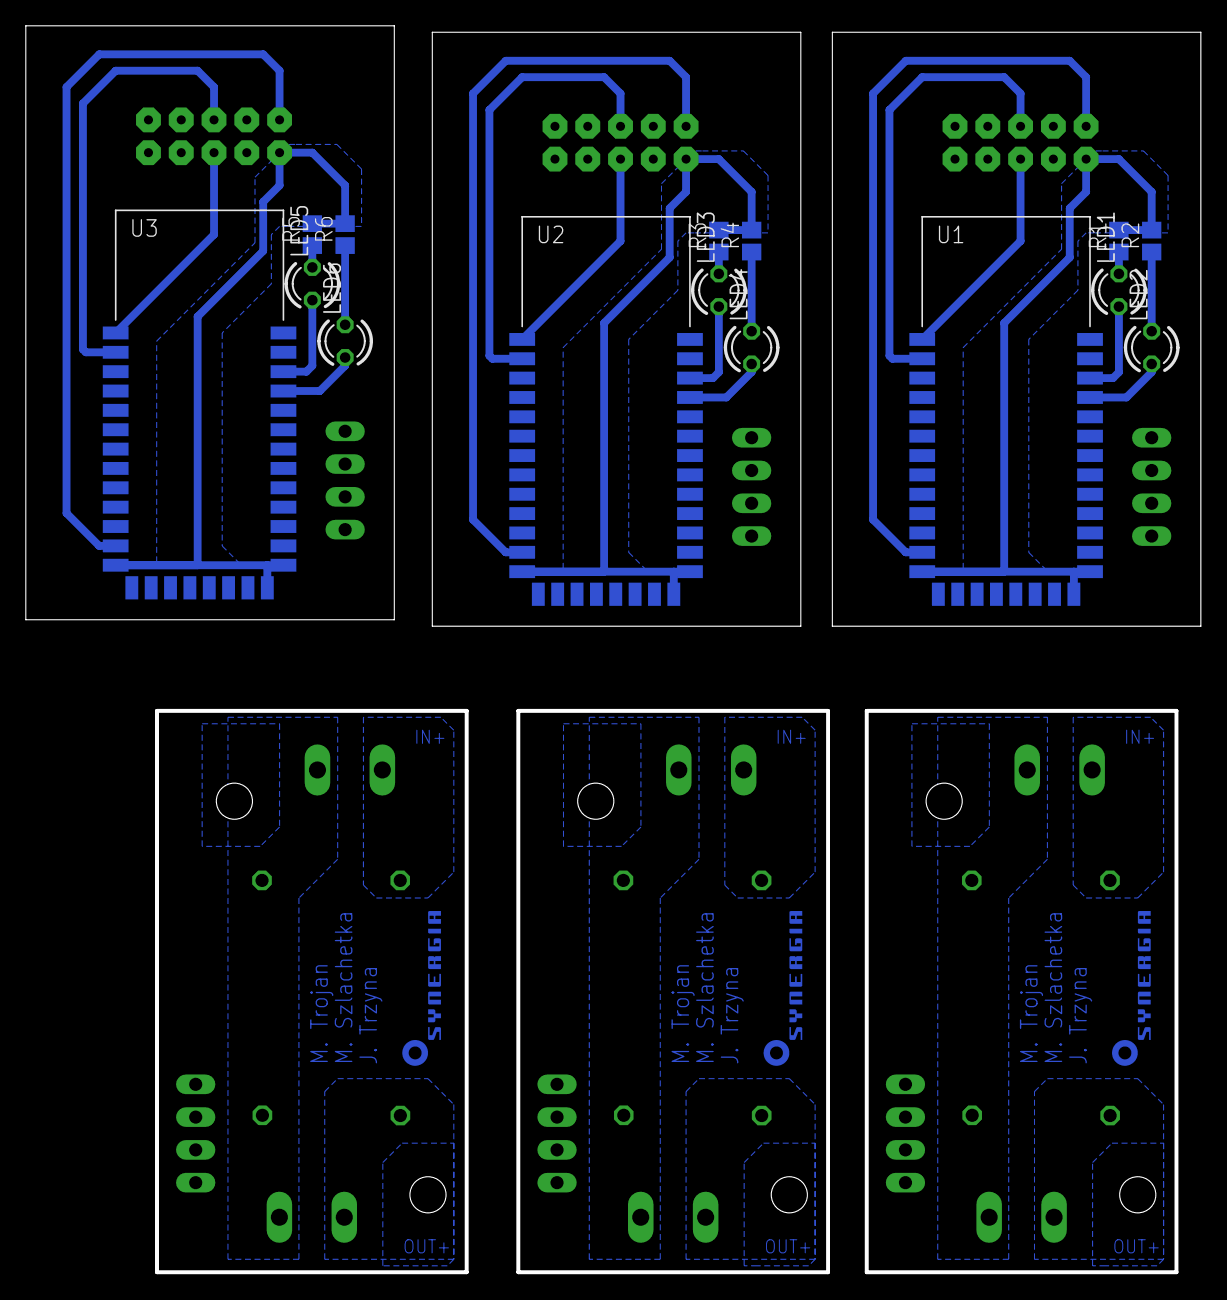
[picture p49: board converter adapter - Copy.brd from below]

Board: 2 copper layers, 91.1 x 96.6 mm, 45 parts (18 on the bottom side), 33 nets.

Parts:
IN, IN1, IN2: AK500/2-H
JP1, JP2, JP3, JP4, JP5, JP6: 1X01
LED1, LED2, LED3, LED4, LED5, LED6: LED3MM
OUT, OUT1, OUT2: AK500/2-H
R1, R2, R3, R4, R5, R6: R0805
SV1, SV2, SV3, SV6, SV8, SV10: MA04-1
SV5, SV7, SV9: ML10
U1, U2, U3: HC_05; BLUETOOTH_SMD
U$1, U$2, U$3: SYNERGIA_12MM
VIN, VIN1, VIN2: 1X01
VOUT, VOUT1, VOUT2: 1X01

Connections:
+3V1: SV5.2, U1.12
+3V2: SV7.2, U2.12
+3V3: SV9.2, U3.12
GND: IN.2, JP2.1, JP4.1, OUT.1
GND1: IN1.2, JP1.1, JP3.1, OUT1.1
GND2: IN2.2, JP5.1, JP6.1, OUT2.1
GND4: R1.2, R2.2, SV5.1, U1.13, U1.21, U1.22
GND5: R3.2, R4.2, SV7.1, U2.13, U2.21, U2.22
GND6: R5.2, R6.2, SV9.1, U3.13, U3.21, U3.22
unnamed: OUT.2, VOUT.1
unnamed: IN.1, VIN.1
unnamed: OUT1.2, VOUT1.1
unnamed: IN1.1, VIN1.1
unnamed: OUT2.2, VOUT2.1
unnamed: IN2.1, VIN2.1
unnamed: SV5.5, U1.1
unnamed: SV5.6, U1.2
unnamed: LED2.A, U1.31
unnamed: LED1.A, U1.32
unnamed: LED1.K, R1.1
unnamed: LED2.K, R2.1
unnamed: SV7.5, U2.1
unnamed: SV7.6, U2.2
unnamed: LED4.A, U2.31
unnamed: LED3.A, U2.32
unnamed: LED3.K, R3.1
unnamed: LED4.K, R4.1
unnamed: SV9.5, U3.1
unnamed: SV9.6, U3.2
unnamed: LED6.A, U3.31
unnamed: LED5.A, U3.32
unnamed: LED5.K, R5.1
unnamed: LED6.K, R6.1
