synergia/Synergolf/(commit log)

2015-05-10 3DC motors, 1Stepper, Communication
    only adc left
    [20126_3D1.ipt, ANSI (cal).dwg, ANSI (cal).idw, ANSI (mm).dwg, ANSI (mm).idw, ASM-SMALL-WHEEL_ASM.0003.iam, ASM-SMALL-WHEEL_ASM.iam, BSI.dwg]
2015-05-13 adc, leds init
    [bt - Copy (2).brd, bt.brd, bt.sch, converter adapter - Copy (2).brd, converter adapter - Copy.brd, converter adapter.sch, zasilanie.sch]
2016-05-13 Smooth putter adjustement. Usart communication improved.
    Quick fixes.
    [parameters.xlsx]
